biodegradablerobotics/biodegradablerobotics.github.io/Code/SamplePynamicsCode-main/SamplePynamicsCode-main/README.md

# SamplePynamicsCode
Supplementary material for ICRA submission 20-2127

Please run 'FinalSimulation' after installing the required packages.
