biodegradablerobotics/biodegradablerobotics.github.io/gallery.md

# Gallery

All images in the repo appear in assignments or are unnecessary duplicates. 

All images can be found [here](https://github.com/biodegradablerobotics/biodegradablerobotics.github.io/tree/main/Images)

A summary of the images of this project is below

## Conceptual CAD Design



## Conceptual Prototype Design

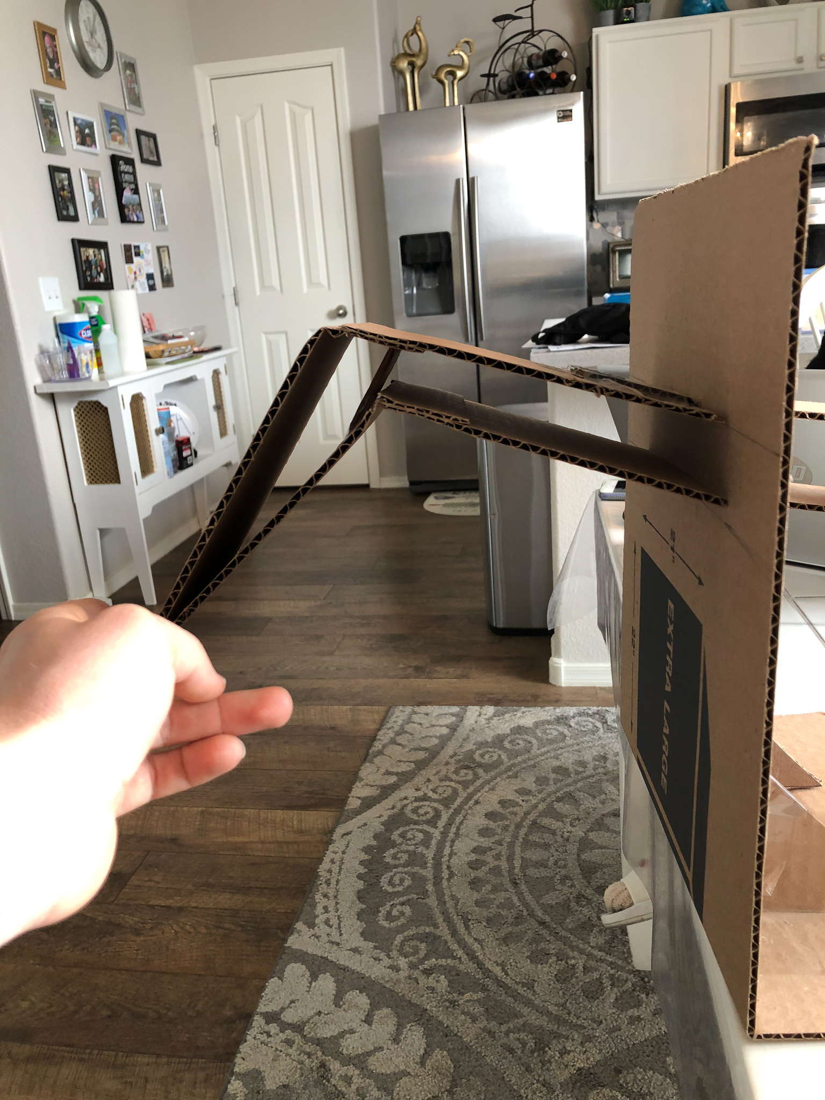
[picture p8: Images/IMG_8056.jpg]


## Foldable CAD Design

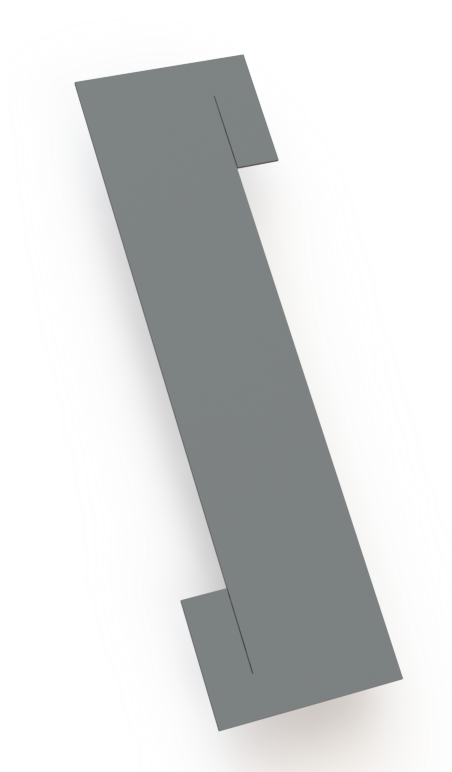
[picture p9: Images/flat - Copy.png]

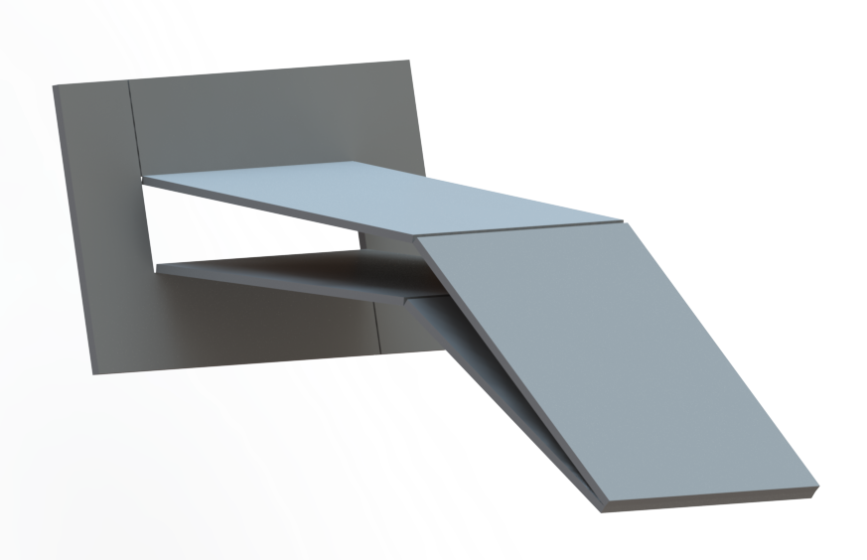
[picture p10: Images/folded.png]


## Foldable Protoype Design

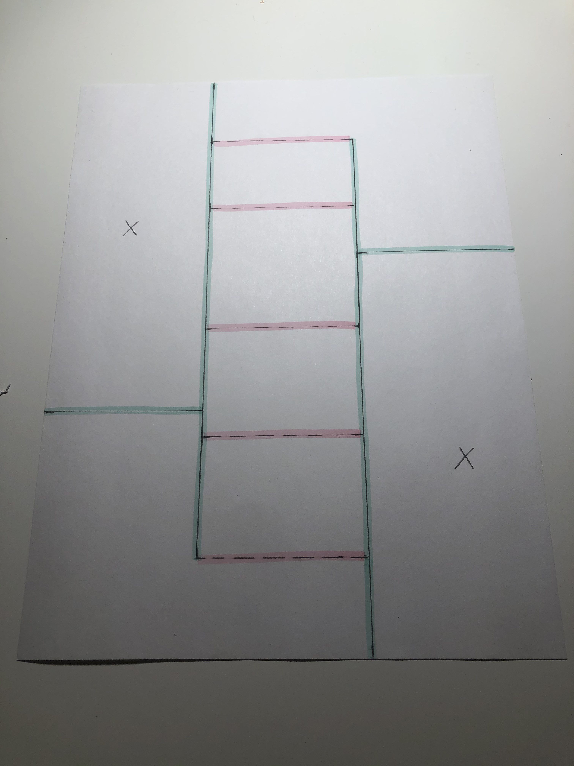
[picture p11: Images/flatpaper.jpg]

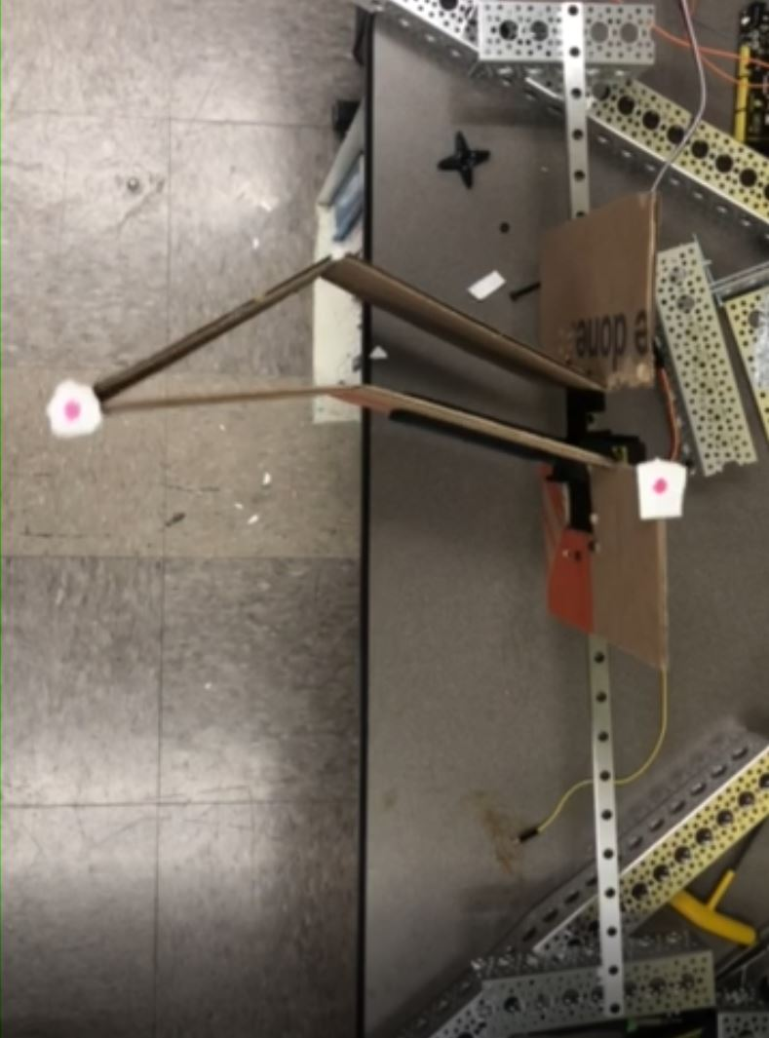
[picture p12: Images/finalproto.JPG]


## Final Simulation

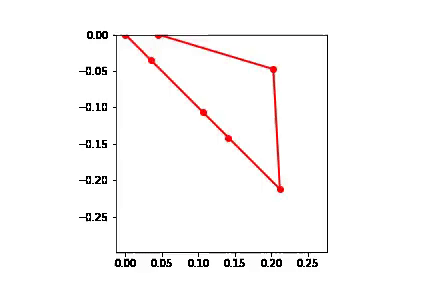
[picture p13: Images/FINALFLAPgif.gif]


## Final Test
