biodegradablerobotics/biodegradablerobotics.github.io/Bibliography.md

# Bibliography

[HOME](index.md)

[1]“Mallard,” Wikipedia, 19-Feb-2021. [Online]. Available: https://en.wikipedia.org/wiki/Mallard.
[Accessed: 28-Feb-2021].

[2] “Mallard Identification, All About Birds, Cornell Lab of Ornithology,” , All About Birds, Cornell
Lab of Ornithology, 2019. [Online]. Available: https://www.allaboutbirds.org/guide/Mallard/id.
[Accessed: 28-Feb-2021].

[3] W. W. Cochran, M. S. Bowlin, and M. Wikelski, “Wingbeat frequency and flap-pause ratio
during natural migratory flight in thrushes,” OUP Academic, 02-Jun-2008. [Online]. Available:
https://academic.oup.com/icb/article/48/1/134/627446. [Accessed: 28-Feb-2021].

[4] K. D. Earls, “Kinematics and mechanics of ground take-off in the starling Sturnis vulgaris and
the quail Coturnix coturnix,” Journal of Experimental Biology, 15-Feb-2000. [Online]. Available:
https://jeb.biologists.org/content/203/4/725. [Accessed: 28-Feb-2021].

[5] U. M. Norberg, “WING DESIGN AND MIGRATORY FLIGHT,” Brill, 12-Apr-1995. [Online].
Available: https://brill.com/view/journals/ijee/41/3/article-p297_11.xml. [Accessed: 28-Feb-2021].

[6] T. Liu, W. M. University, K. Kuykendoll, N. A. S. A. L. R. Center, R. Rhew, S. Jones, C.
Harvey, J. P. Calogero, K. Kitamura, K. Kitamura, Gavin K. Ananda and Michael S. Selig, D.
Kumar, M. Hamdaoui, S. Klän, Pradeep Gopalakrishnan and Danesh K. Tafti, J. T. Black, C.
Svanberg, S. Pantula, J. Jackson, R. Unger, S. Bansmer, and W. L. S. Pantula, “Avian Wing
Geometry and Kinematics,” AIAA Journal, 02-May-2012. [Online]. Available:
https://arc.aiaa.org/doi/abs/10.2514/1.16224?casa_token=r6aivCuGqMgAAAAA%3Ap7HvCTCP
ssW98Qedh3qjCwQa3h6oTVcNZ6BCSFze0NS6uCvBZKfUV_2CfwQQ2x-zJE9muAHnl9A&.
[Accessed: 28-Feb-2021].

[7] Send, W. & Fischer, M. & Jebens, K. & Mugrauer, R. & Nagarathinam, A. & Scharstein, F..
(2012). Artificial hinged-wing bird with active torsion and partially linear kinematics. 28th
Congress of the International Council of the Aeronautical Sciences 2012, ICAS 2012. 2.
1148-1157.

[8] “Festo Bionic Flying Fox,” Pneumatic & electric automation technology, Mar-2018. [Online].
Available: https://www.festo.com/PDF_Flip/corp/Festo_BionicFlyingFox/en/. [Accessed:
28-Feb-2021].

[9] F. Nickols and Y. J. Lin, "Feathered tail and pygostyle for the flying control of a bio-mimicking
eagle bird robot," 2017 IEEE International Conference on Cybernetics and Intelligent Systems
(CIS) and IEEE Conference on Robotics, Automation and Mechatronics (RAM), Ningbo, China,
2017, pp. 556-561, doi: 10.1109/ICCIS.2017.8274837.
8

[10] C.-S. Lin, C. Hwu, and W.-B. Young, “The thrust and lift of an ornithopter's membrane wings
with simple flapping motion,” Aerospace Science and Technology, 01-Dec-2005. [Online].
Available: https://www.sciencedirect.com/science/article/abs/pii/S1270963805001525.
[Accessed: 28-Feb-2021].

[11] J. W. Gerdes, S. K. Gupta, and S. A. Wilkerson, “A Review of Bird-Inspired Flapping Wing
Miniature Air Vehicle Designs,” Journal of Mechanisms and Robotics, 01-May-2012. [Online].
Available:
https://asmedigitalcollection.asme.org/mechanismsrobotics/article-abstract/4/2/021003/467462/
A-Review-of-Bird-Inspired-Flapping-Wing-Miniature?redirectedFrom=fulltext. [Accessed:
28-Feb-2021].

[12] “BEGINNERS FPV DRONE GUIDE,” Custom Quads. [Online]. Available:
https://customquads.com.au/pages/fpv-beginners-start-here#:~:text=To%20build%20a%20stand
ard%20FPV,800%20grams%20with%20a%20battery. [Accessed: 28-Feb-2021].

[13] “Pololu - 150:1 Micro Metal Gearmotor MP 6V,” Pololu Robotics & Electronics. [Online].
Available: https://www.pololu.com/product/2368/specs. [Accessed: 07-Feb-2021].

[14] “AKZYTUE 3.7V 400mAh 802525 Lipo Battery Rechargeable Lithium Polymer ion Battery
Pack with JST Connector,” Amazon.com. [Online]. Available:
https://www.amazon.com/AKZYTUE-Battery-Rechargeable-Lithium-Connector/dp/B07TVDNQN
S/ref=sr_1_2?dchild=1&keywords=3.7V+400mAh+Lithium+Polymer&qid=1612665237&s=hpc&
sr=1-2. [Accessed: 06-Feb-2021].

[15] T. Allen and Y. Tavares, “Planes and Birds: Minimizing Energy,” Santa Fe College, 2018.
[Online]. Available: https://www.sfcollege.edu/Assets/sf/rue/pdfs/2017/allen.pdf. [Accessed:
28-Feb-2021].

[16] Caramin, Bénédicte & Dunn, Iain & Ney, Rauno & Klawikowski, Yvonne & Duarte, Abel &
Malheiro, Benedita & Ribeiro, Cristina & Ferreira, Fernando & Silva, Manuel & Ferreira, Paulo &
Guedes, Pedro. (2015). Design and Implementation of a Biologically Inspired Flying Robot - An
EPS@ISEP 2014 Spring Project. 10.1145/2808580.2808612

[17] Zoheir Aboura, Nabil Talbi, Samir Allaoui, Malk Benzeggagh. Elastic behavior of corrugated cardboard: Experiments and Modeling. Composite Structures, Elsevier, 2004, 63 (1), pp.53-62. 

[18] [https://nbviewer.jupyter.org/url/biodegradablerobotics.github.io/Code/VirtualJoint.ipynb](https://nbviewer.jupyter.org/url/biodegradablerobotics.github.io/Code/VirtualJoint.ipynb)

[HOME](index.md)
