biodegradablerobotics/biodegradablerobotics.github.io/cad.md

# CAD


Solidworks files can be downloaded [here](https://github.com/biodegradablerobotics/biodegradablerobotics.github.io/blob/main/Manufacturing/Solidworks%20files.zip)

# DXF
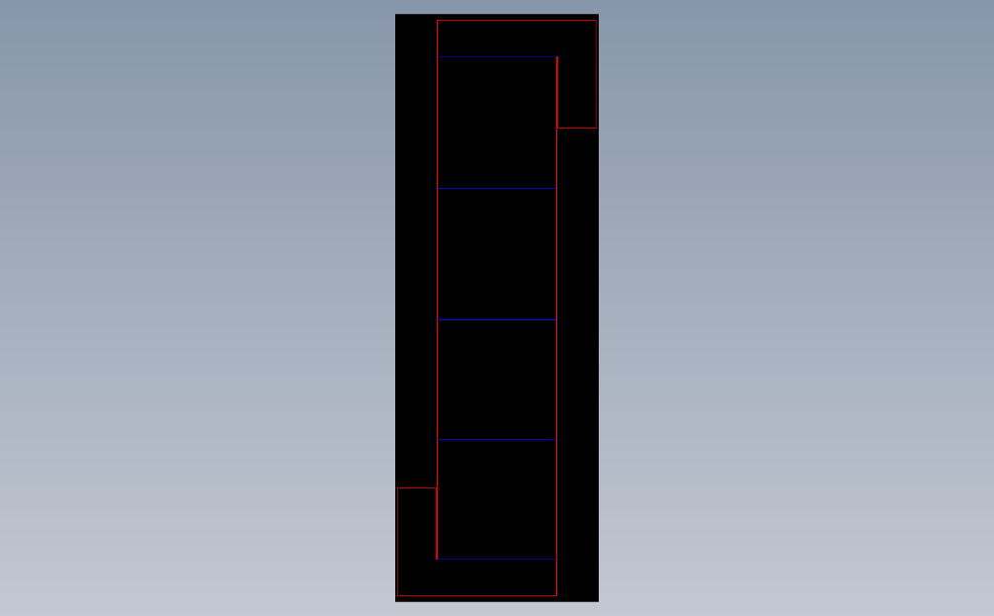
[picture p113: Manufacturing/images/design.png]


dxf files can be downloaded [here](https://github.com/biodegradablerobotics/biodegradablerobotics.github.io/blob/main/Manufacturing/dxf%20files.zip)
