biodegradablerobotics/biodegradablerobotics.github.io/Images/duckBG.jpg

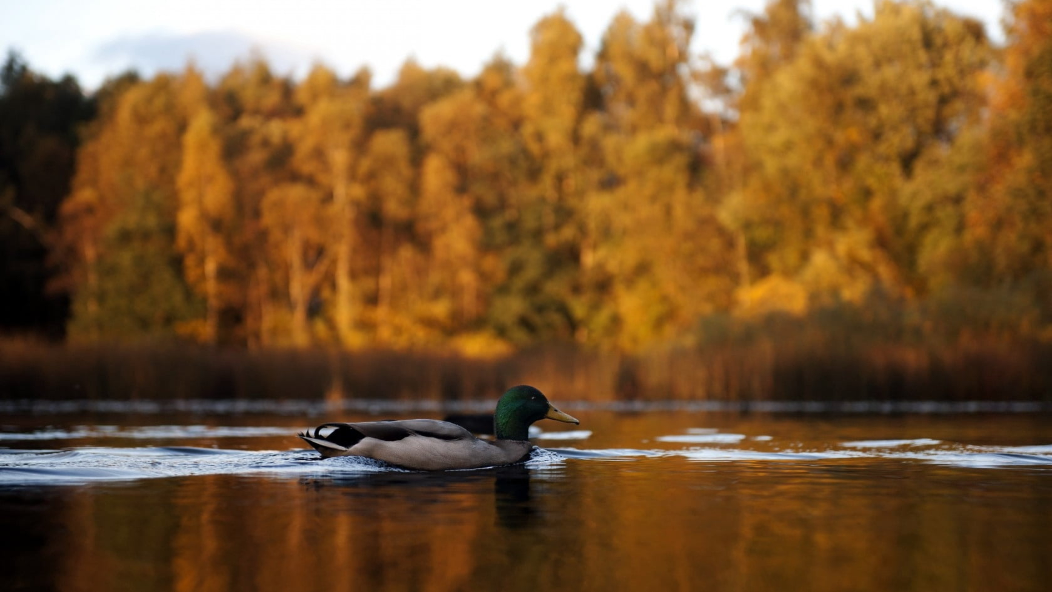
Images/duckBG.jpg
