biodegradablerobotics/biodegradablerobotics.github.io/Images/DynamicsB0/angles.png

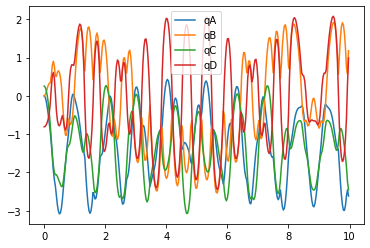
Images/DynamicsB0/angles.png
