biodegradablerobotics/biodegradablerobotics.github.io/Images/DynamicsB0/animation.gif

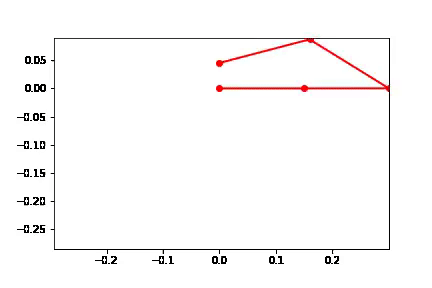
Images/DynamicsB0/animation.gif
