biodegradablerobotics/biodegradablerobotics.github.io/Images/DynamicsB0/energy.png

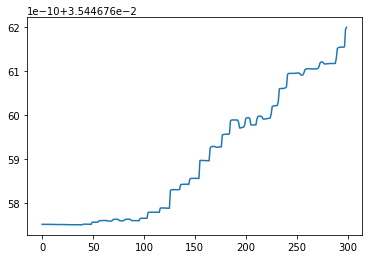
Images/DynamicsB0/energy.png
