biodegradablerobotics/biodegradablerobotics.github.io/Images/DynamicsB0/finalframe.png

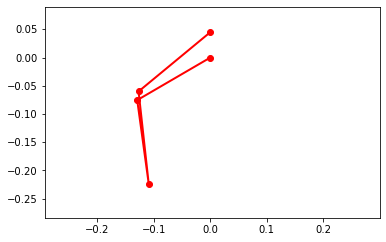
Images/DynamicsB0/finalframe.png
