biodegradablerobotics/biodegradablerobotics.github.io/Images/DynamicsB0/frames.png

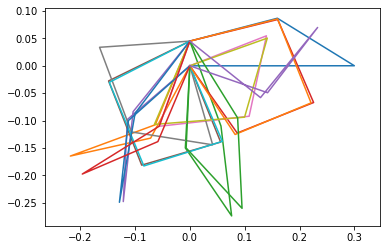
Images/DynamicsB0/frames.png
