biodegradablerobotics/biodegradablerobotics.github.io/Images/flat.png

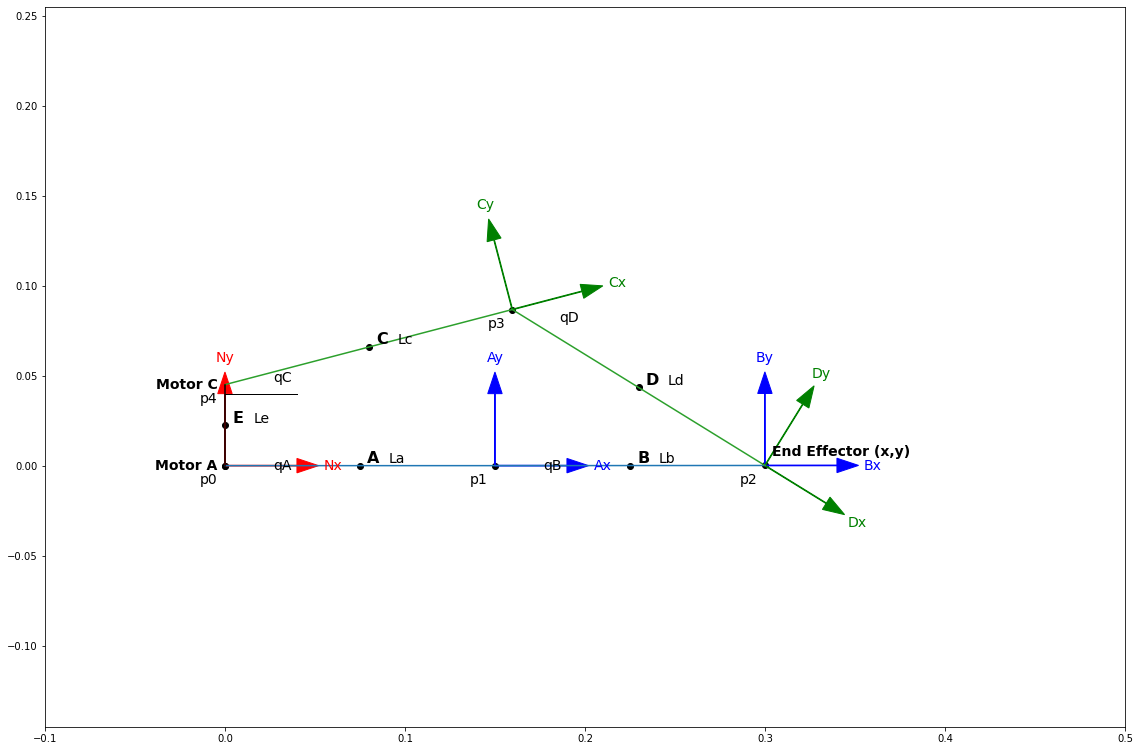
Images/flat.png
