biodegradablerobotics/biodegradablerobotics.github.io/Images/IMG_8039.jpg

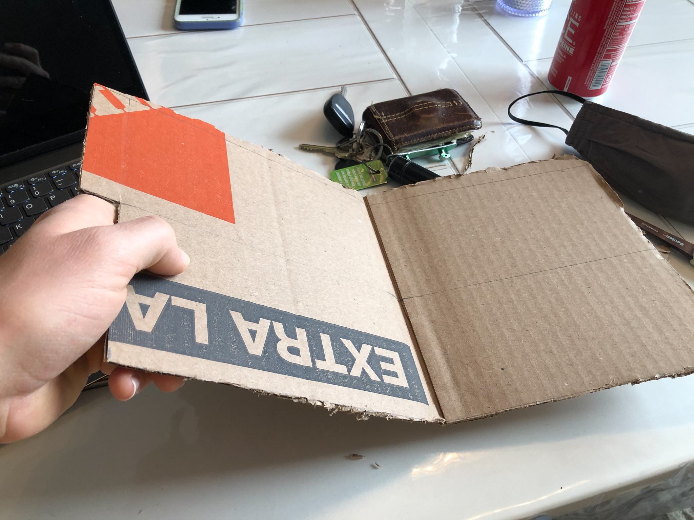
Images/IMG_8039.jpg
