biodegradablerobotics/biodegradablerobotics.github.io/Images/IMG_8041.jpg

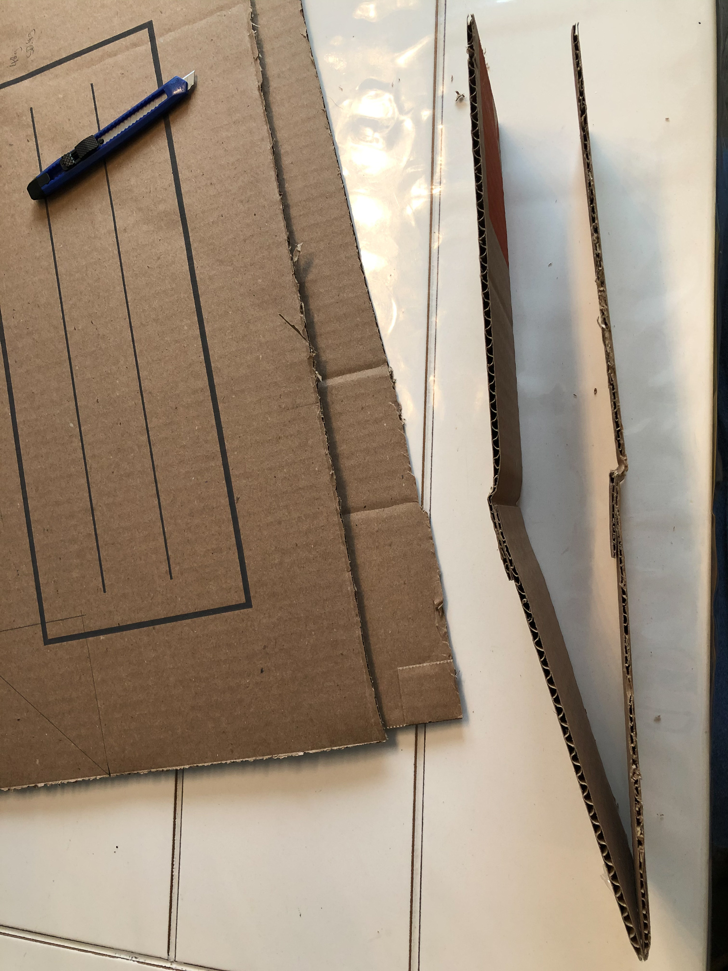
Images/IMG_8041.jpg
