biodegradablerobotics/biodegradablerobotics.github.io/Images/IMG_8042.jpg

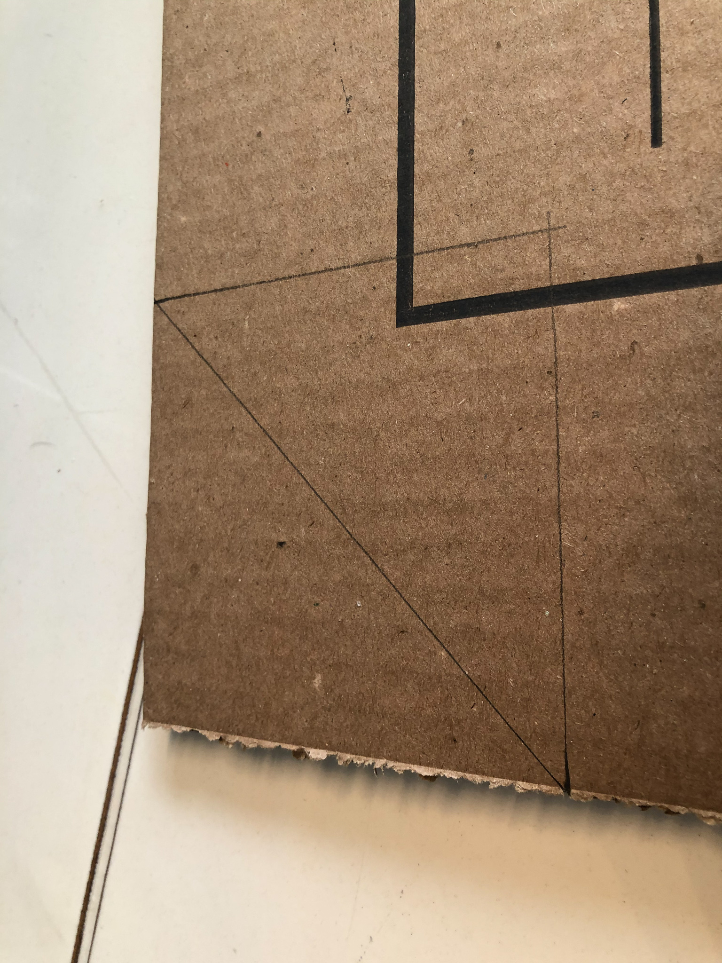
Images/IMG_8042.jpg
