biodegradablerobotics/biodegradablerobotics.github.io/Images/IMG_8043.jpg

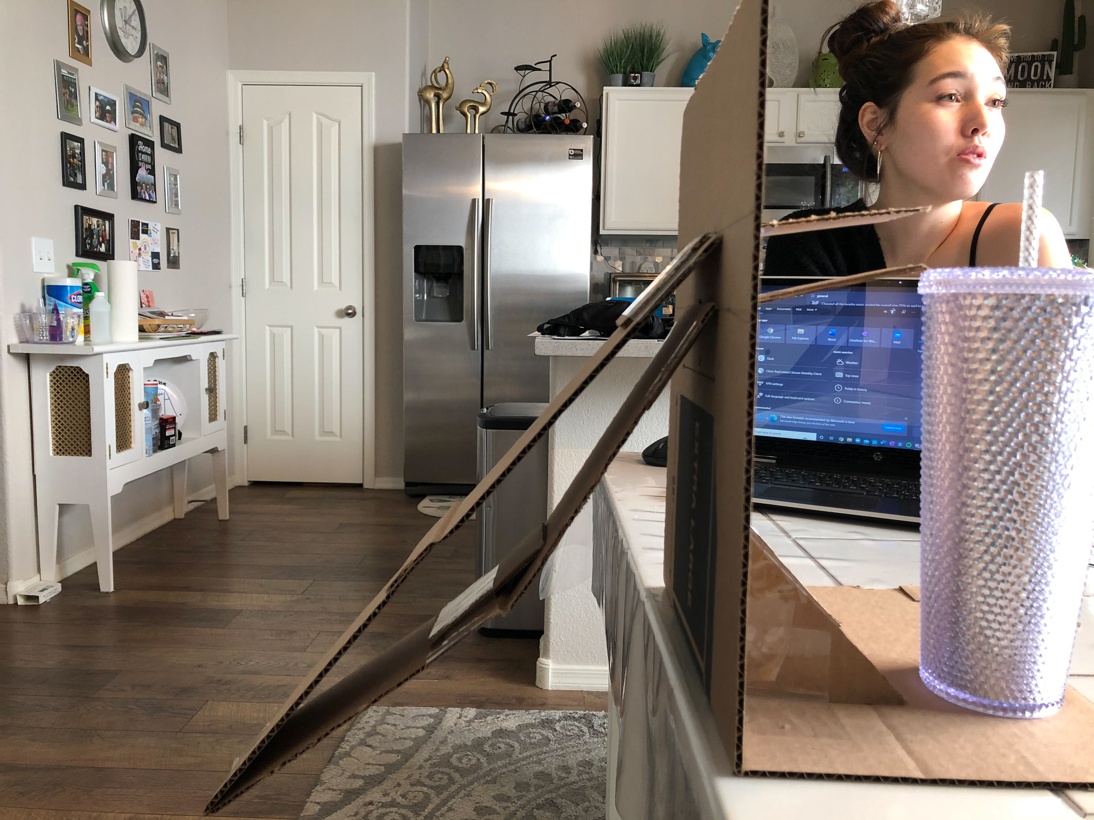
Images/IMG_8043.jpg
