biodegradablerobotics/biodegradablerobotics.github.io/Images/IMG_8046.jpg

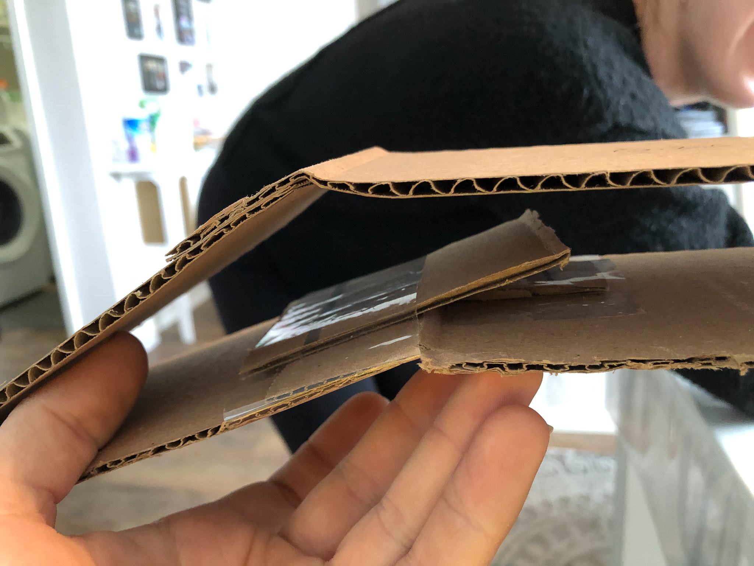
Images/IMG_8046.jpg
