biodegradablerobotics/biodegradablerobotics.github.io/Images/IMG_8047.jpg

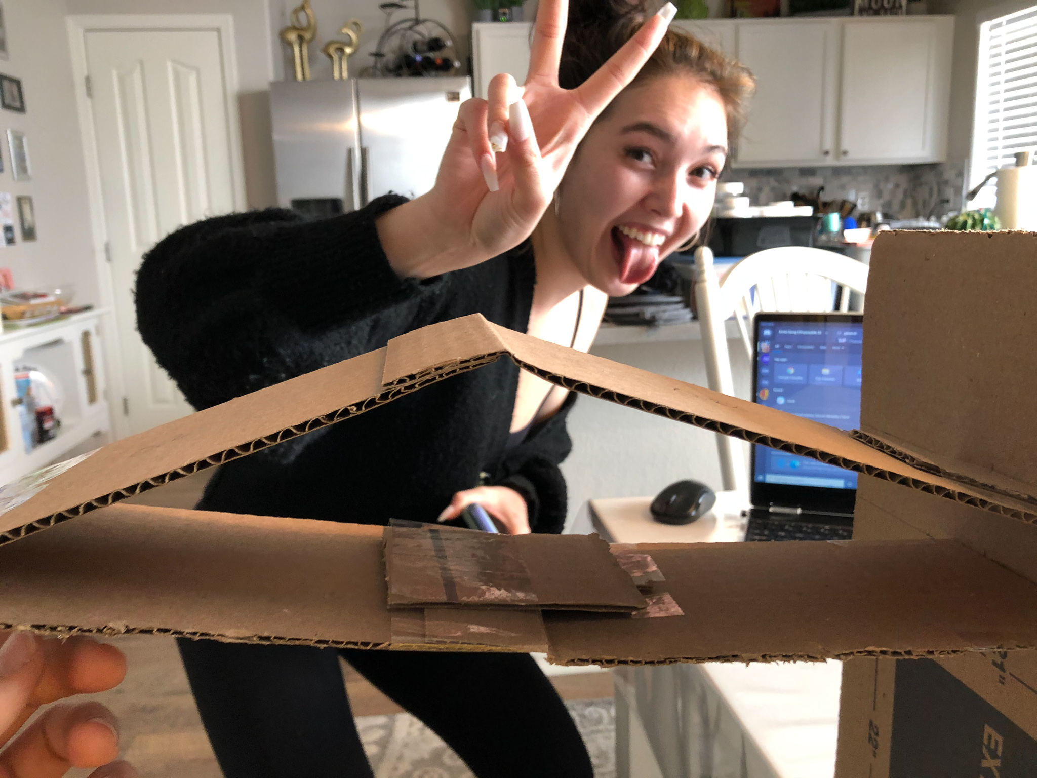
Images/IMG_8047.jpg
