biodegradablerobotics/biodegradablerobotics.github.io/Images/IMG_8052.jpg

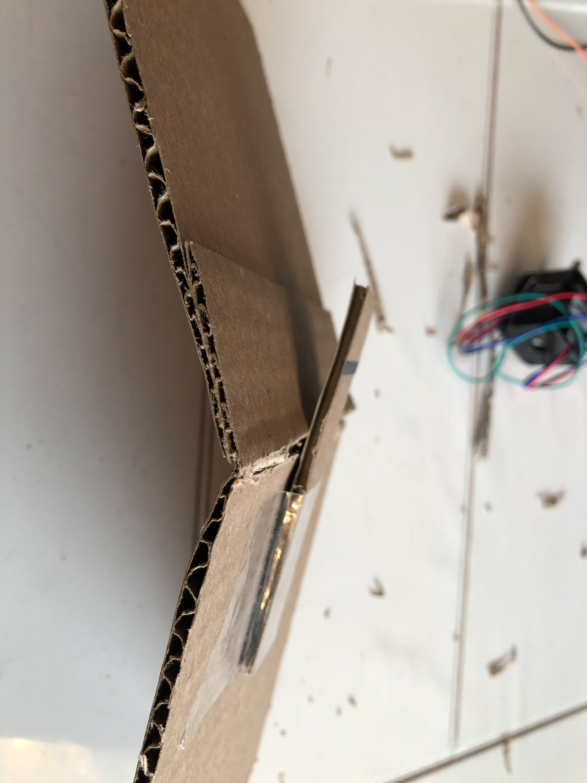
Images/IMG_8052.jpg
