biodegradablerobotics/biodegradablerobotics.github.io/Images/new graph.png

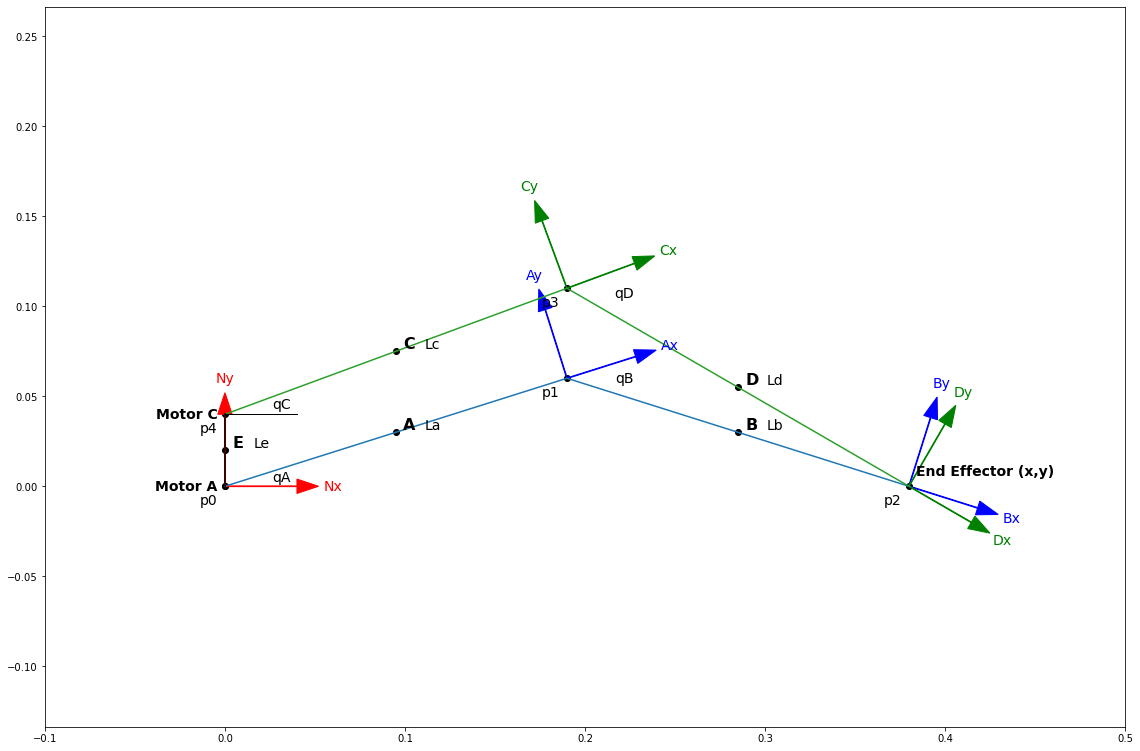
Images/new graph.png
