biodegradablerobotics/biodegradablerobotics.github.io/Images/paper wing reduce.jpeg

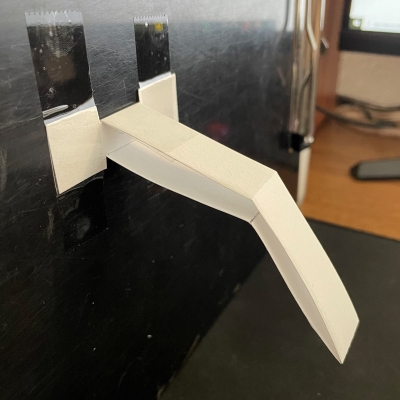
Images/paper wing reduce.jpeg
