biodegradablerobotics/biodegradablerobotics.github.io/Images/Servo.PNG

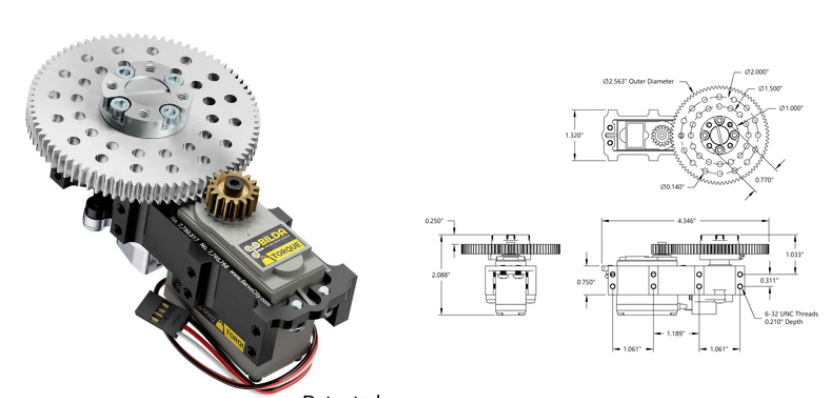
Images/Servo.PNG
