biodegradablerobotics/biodegradablerobotics.github.io/Images/tracker_sim.jpg

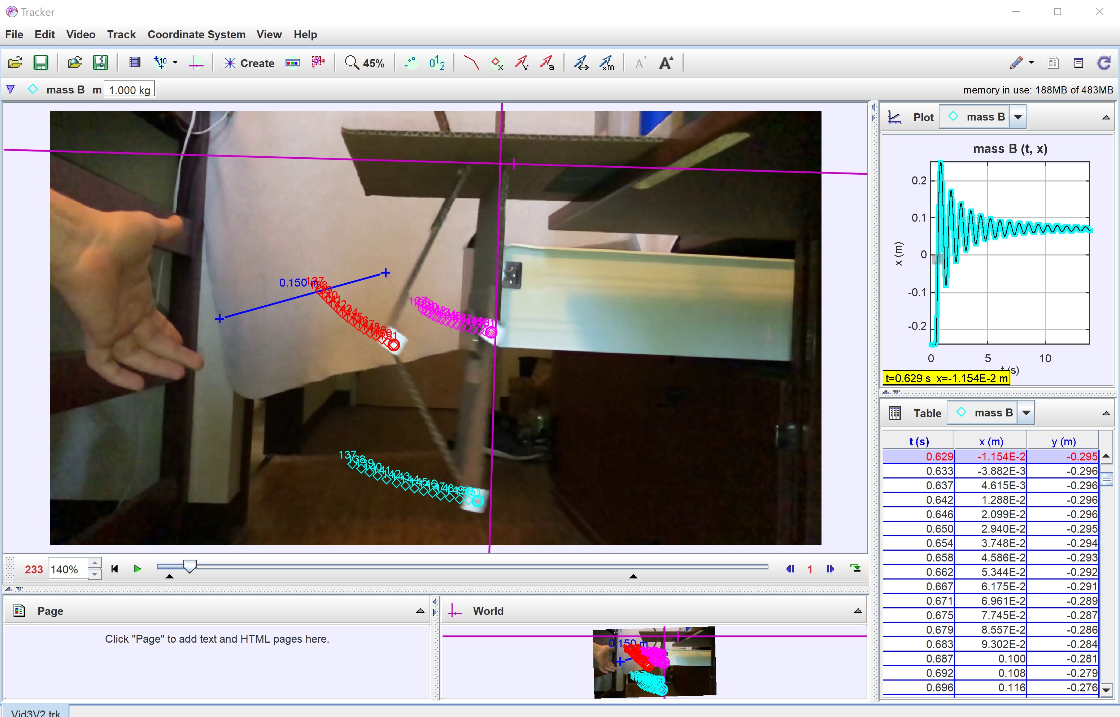
Images/tracker_sim.jpg
