biodegradablerobotics/biodegradablerobotics.github.io/Images/wingdiagram.png

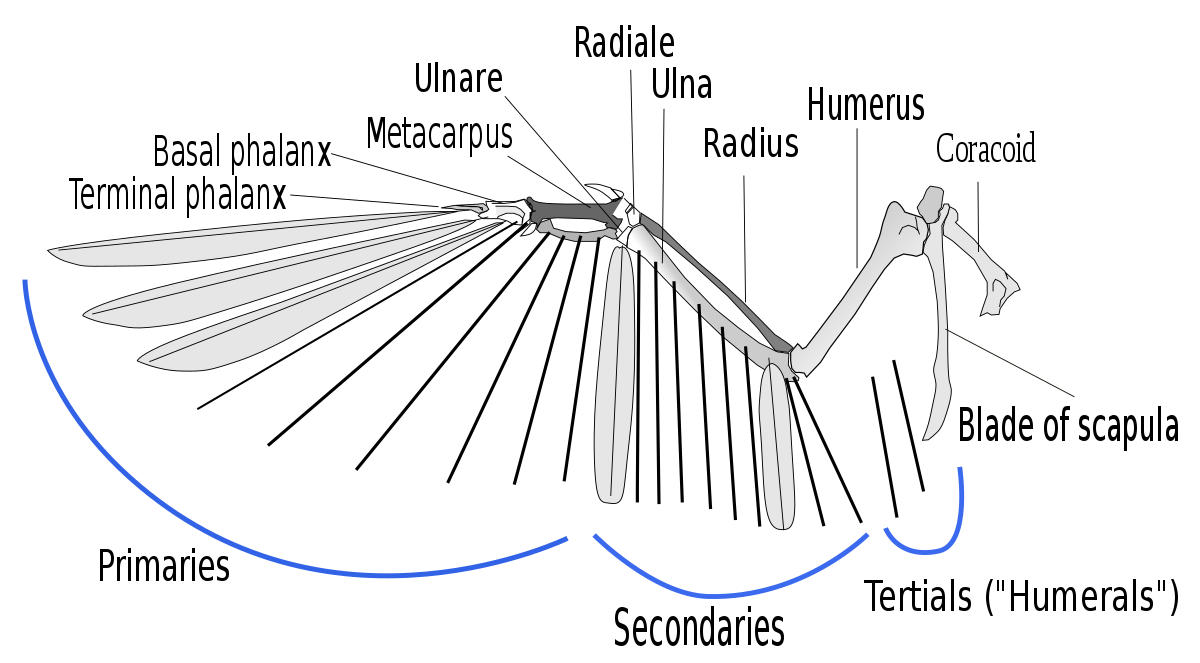
Images/wingdiagram.png
