biodegradablerobotics/biodegradablerobotics.github.io/Manufacturing/SW/folded.SLDASM

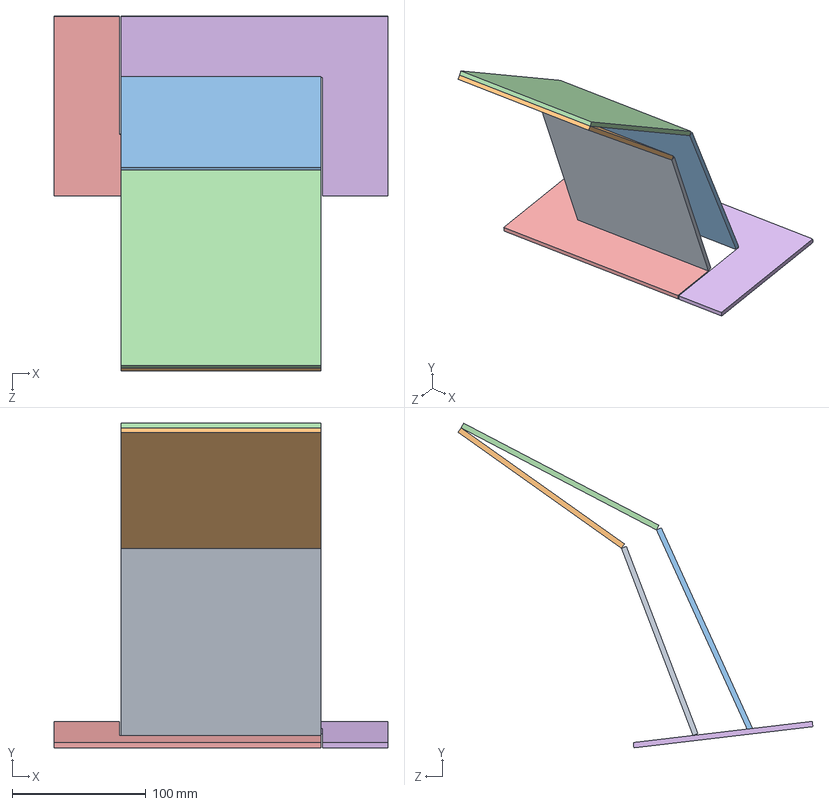
[picture p147: CAD file, 2021-04-12]
Manufacturing/SW/folded.SLDASM
250.0 x 243.0 x 265.7 mm
A
B
C
D
EA
EC
