biodegradablerobotics/biodegradablerobotics.github.io/SolidWorks/Compliant/Compliant Assembly.SLDASM

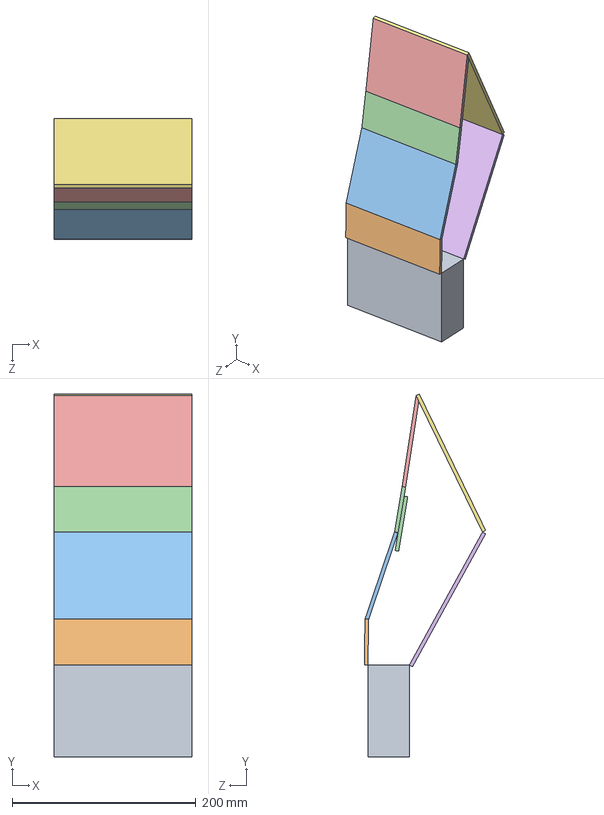
[picture p148: CAD file, 2021-03-20]
SolidWorks/Compliant/Compliant Assembly.SLDASM
150.0 x 394.7 x 132.1 mm
E
Aa
Ab
Ba
Bb
C
D
