biodegradablerobotics/biodegradablerobotics.github.io/Manufacturing/SW/flat.SLDASM

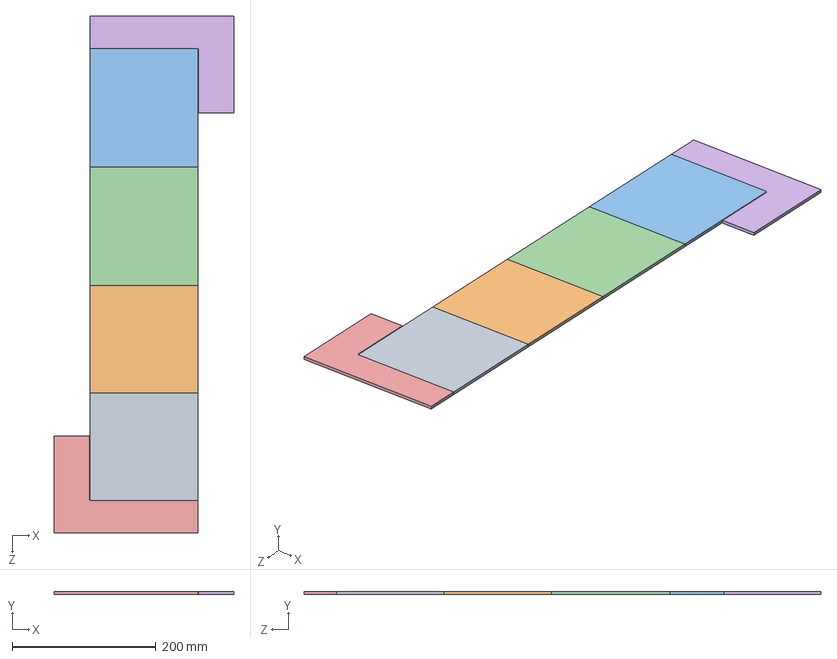
[picture p149: CAD file, 2021-04-12]
Manufacturing/SW/flat.SLDASM
250.0 x 4.00 x 720.0 mm
A
B
C
D
EA
EC
