biodegradablerobotics/biodegradablerobotics.github.io/SolidWorks/Wing Assembly.SLDASM

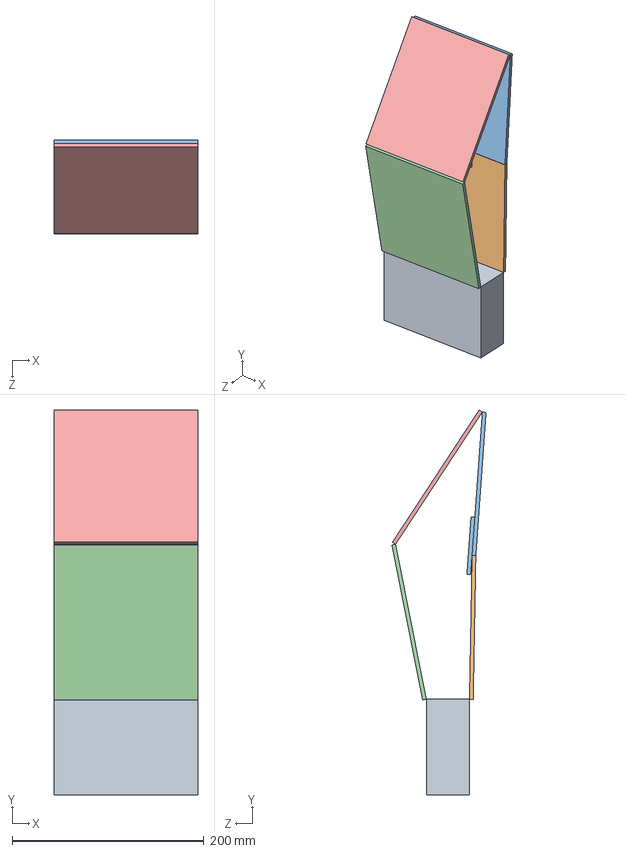
[picture p150: CAD file, 2021-03-15]
SolidWorks/Wing Assembly.SLDASM
150.0 x 402.0 x 98.4 mm
E
A
B
C
D
