biodegradablerobotics/biodegradablerobotics.github.io/Manufacturing/first_pass0.dxf

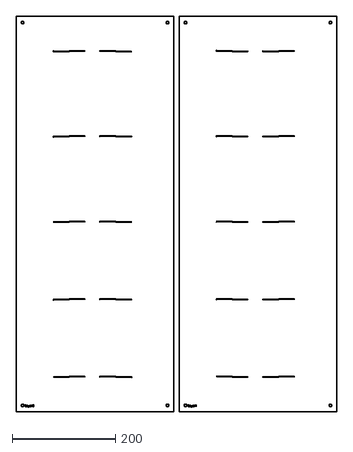
[picture p151: CAD file, 2021-04-26]
Manufacturing/first_pass0.dxf
619.8 x 764.9
