biodegradablerobotics/biodegradablerobotics.github.io/Manufacturing/SW/EA.SLDPRT

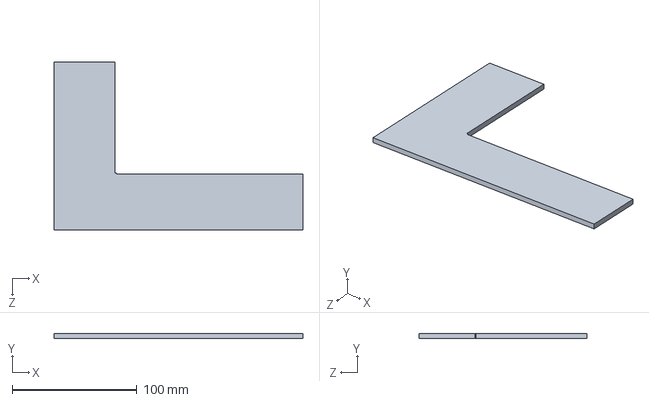
[picture p152: CAD file, 2021-04-12]
Manufacturing/SW/EA.SLDPRT
200.0 x 4.00 x 135.0 mm
