biodegradablerobotics/biodegradablerobotics.github.io/SolidWorks/Compliant/Ba.SLDPRT

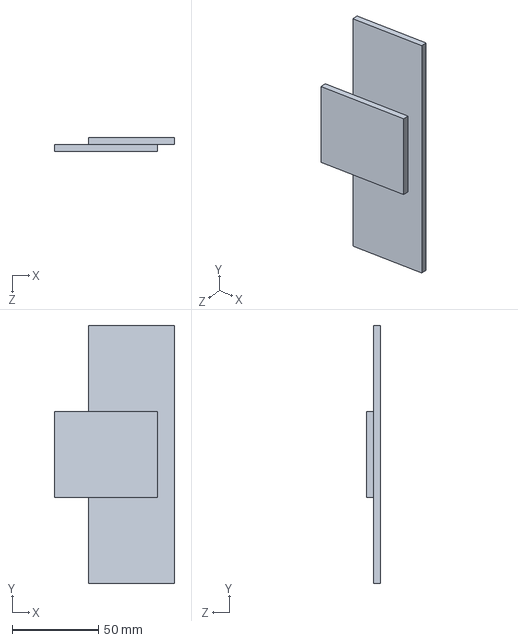
[picture p153: CAD file, 2021-03-20]
SolidWorks/Compliant/Ba.SLDPRT
70.0 x 150.0 x 8.00 mm
