biodegradablerobotics/biodegradablerobotics.github.io/Manufacturing/first_pass2.dxf

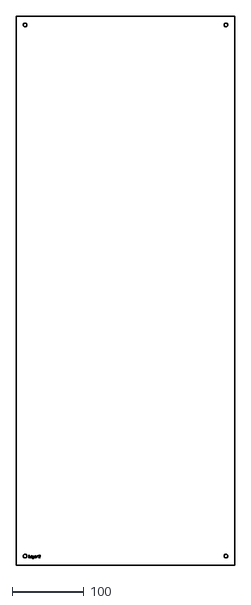
[picture p154: CAD file, 2021-04-26]
Manufacturing/first_pass2.dxf
304.9 x 764.9
