biodegradablerobotics/biodegradablerobotics.github.io/SolidWorks/D.SLDPRT

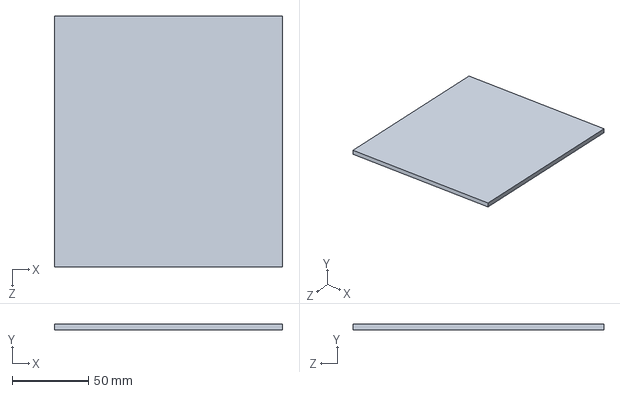
[picture p155: CAD file, 2021-03-20]
SolidWorks/D.SLDPRT
150.0 x 4.00 x 165.0 mm
