biodegradablerobotics/biodegradablerobotics.github.io/Manufacturing/final_cut.dxf

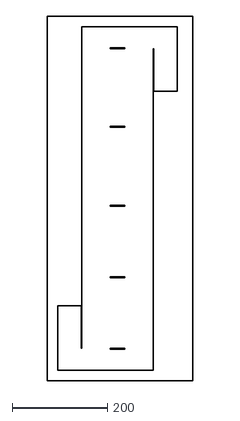
[picture p156: CAD file, 2021-04-26]
Manufacturing/final_cut.dxf
304.9 x 764.9
