biodegradablerobotics/biodegradablerobotics.github.io/SolidWorks/Compliant/Ab.SLDPRT

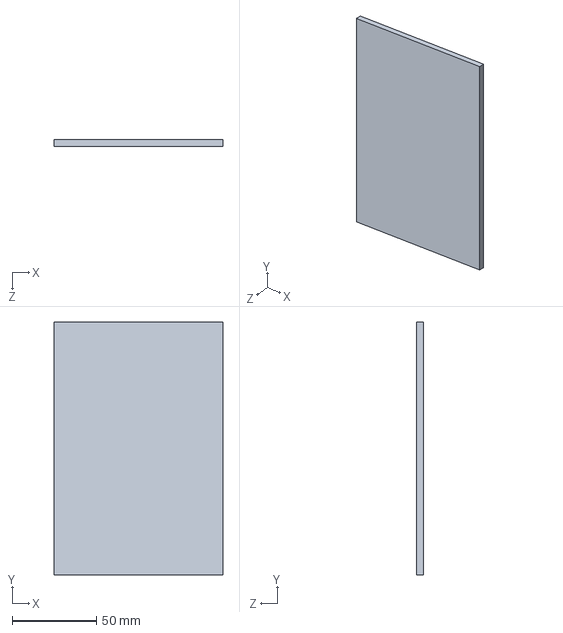
[picture p157: CAD file, 2021-03-20]
SolidWorks/Compliant/Ab.SLDPRT
100.0 x 150.0 x 4.00 mm
