biodegradablerobotics/biodegradablerobotics.github.io/Manufacturing/design.dxf

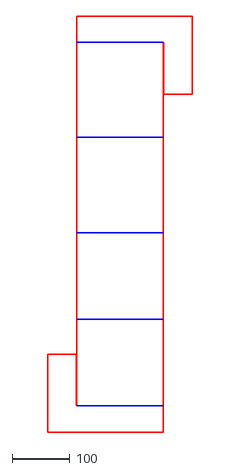
[picture p158: CAD file, 2021-04-26]
Manufacturing/design.dxf
250.0 x 720.0
