biodegradablerobotics/biodegradablerobotics.github.io/Manufacturing/first_pass1.dxf

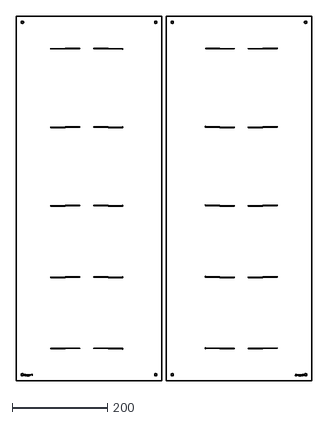
[picture p159: CAD file, 2021-04-26]
Manufacturing/first_pass1.dxf
619.8 x 764.9
