biodegradablerobotics/biodegradablerobotics.github.io/SolidWorks/B.SLDPRT

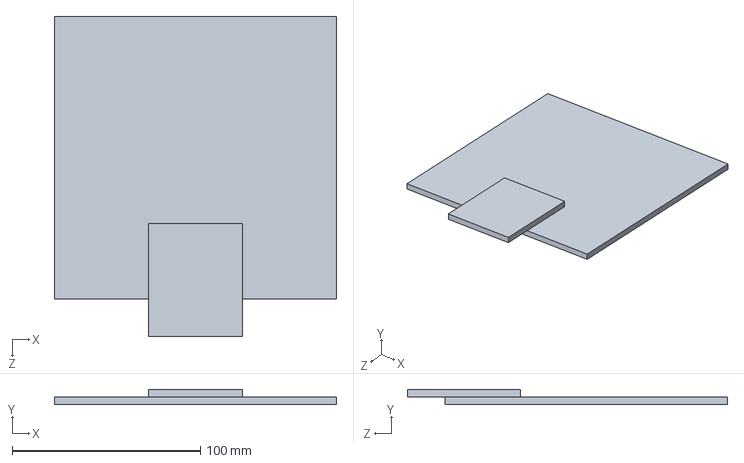
[picture p160: CAD file, 2021-03-15]
SolidWorks/B.SLDPRT
150.0 x 8.00 x 170.0 mm
