biodegradablerobotics/biodegradablerobotics.github.io/SolidWorks/Compliant/Aa.SLDPRT

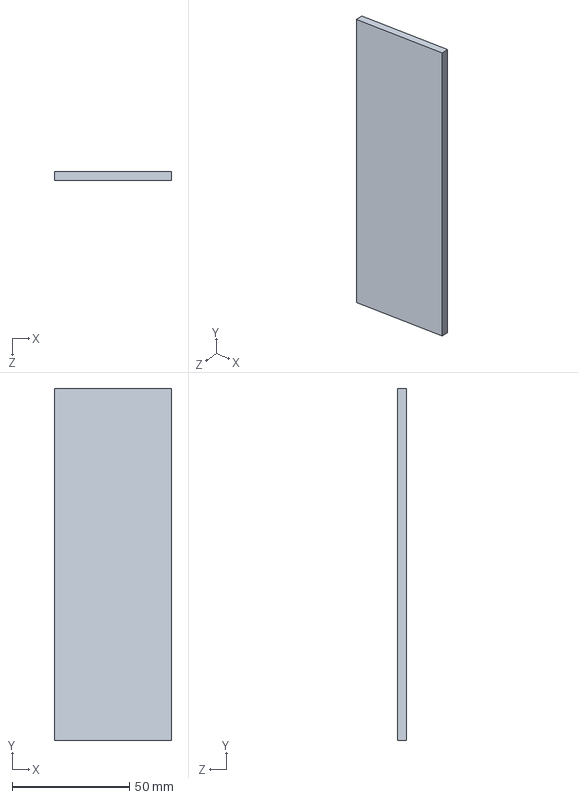
[picture p161: CAD file, 2021-03-20]
SolidWorks/Compliant/Aa.SLDPRT
50.0 x 150.0 x 4.00 mm
