biodegradablerobotics/biodegradablerobotics.github.io/SolidWorks/A.SLDPRT

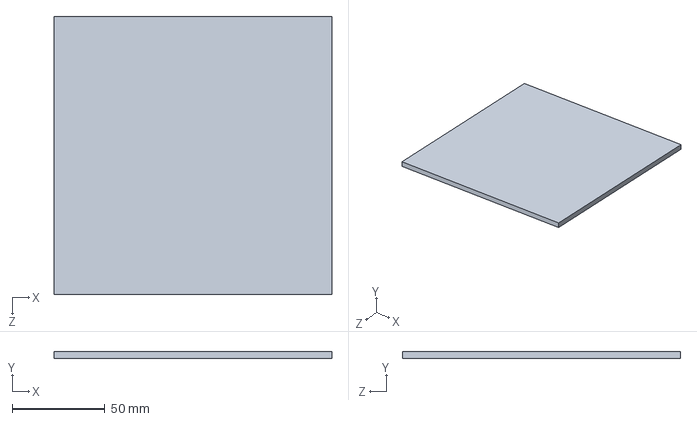
[picture p162: CAD file, 2021-03-15]
SolidWorks/A.SLDPRT
150.0 x 4.00 x 150.0 mm
