biodegradablerobotics/biodegradablerobotics.github.io/SolidWorks/Compliant/Da.SLDPRT

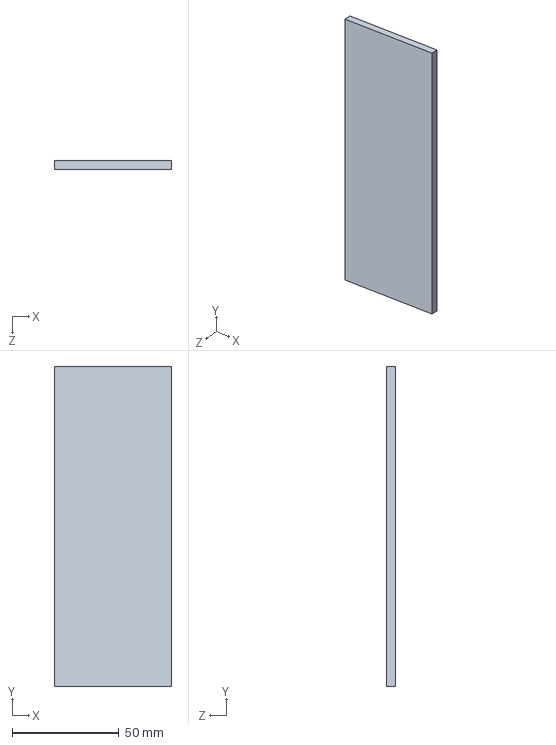
[picture p163: CAD file, 2021-03-17]
SolidWorks/Compliant/Da.SLDPRT
55.0 x 150.0 x 4.00 mm
