biodegradablerobotics/biodegradablerobotics.github.io/SolidWorks/Compliant/Db.SLDPRT

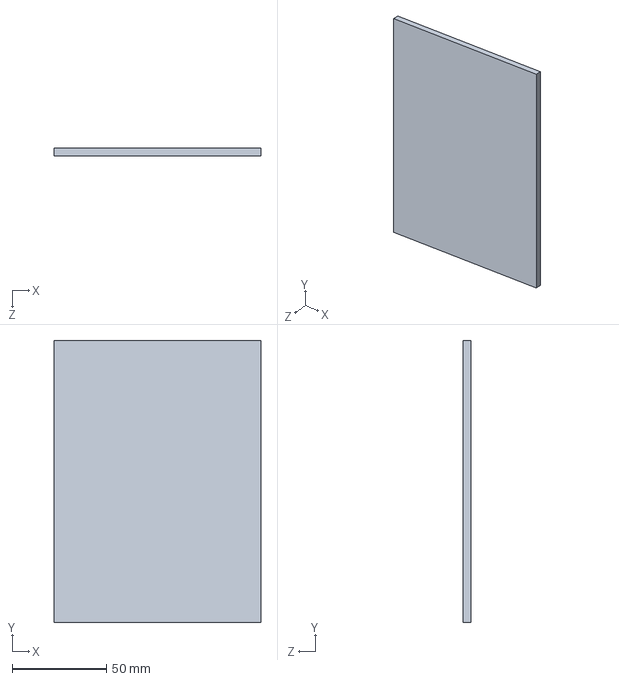
[picture p164: CAD file, 2021-03-17]
SolidWorks/Compliant/Db.SLDPRT
110.0 x 150.0 x 4.00 mm
