biodegradablerobotics/biodegradablerobotics.github.io/Manufacturing/SW/2D1Layer.SLDPRT

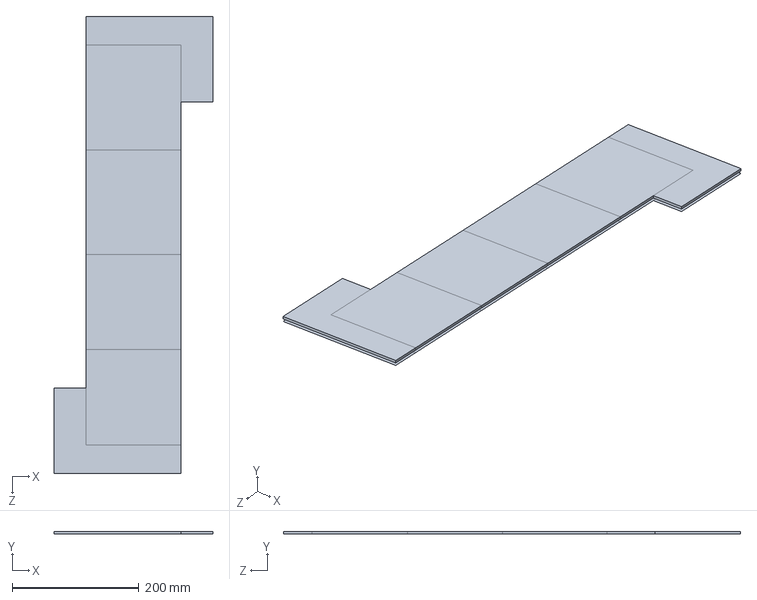
[picture p165: CAD file, 2021-04-09]
Manufacturing/SW/2D1Layer.SLDPRT
250.0 x 8.00 x 720.0 mm
