biodegradablerobotics/biodegradablerobotics.github.io/SolidWorks/Compliant/E.SLDPRT

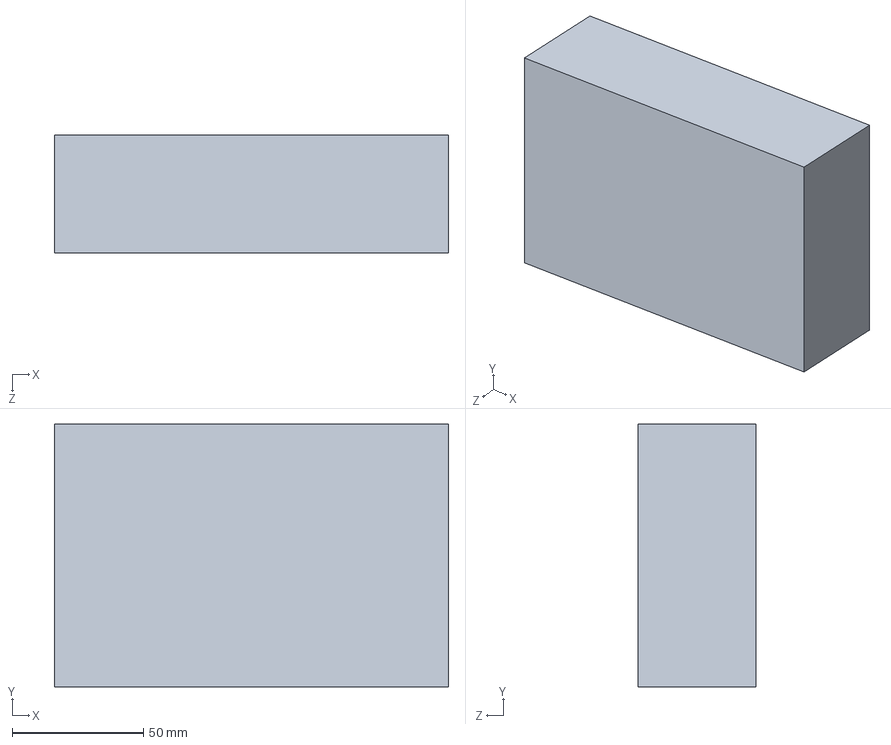
[picture p166: CAD file, 2021-03-15]
SolidWorks/Compliant/E.SLDPRT
150.0 x 100.0 x 45.0 mm
