biodegradablerobotics/biodegradablerobotics.github.io/(list of files, cad)

Other CAD files:
SolidWorks/2D_5bar.SLDPRT
SolidWorks/C.SLDPRT
Manufacturing/SW/EC.SLDPRT
SolidWorks/Compliant/Bb.SLDPRT
Manufacturing/SW/C.SLDPRT
Manufacturing/SW/A.SLDPRT
Manufacturing/SW/D.SLDPRT
SolidWorks/Compliant/Ca.SLDPRT
Manufacturing/SW/B.SLDPRT
SolidWorks/Compliant/Cb.SLDPRT
Manufacturing/SW/flat.SLDDRW
