biodegradablerobotics/biodegradablerobotics.github.io/(commit log)

2021-02-11 wing video
2021-02-12 Create Team System Kinematics.ipynb
2021-02-12 Create Team System Kinematics-checkpoint.ipynb
2021-02-15 Update Team System Kinematics-checkpoint.ipynb
2021-02-15 Update Team System Kinematics.ipynb
2021-02-15 wing kinematics
2021-02-16 update wing kinematics
2021-02-17 Create Wing Kinematics-checkpoint.ipynb
2021-02-17 Create paper wing reduce.jpeg
2021-02-17 Create paper wing.jpeg
2021-02-17 Create Wing Kinematics.ipynb
2021-02-22 SW and renders
    [2D_5bar.SLDPRT, A.SLDPRT, B.SLDPRT, C.SLDPRT, D.SLDPRT, E.SLDPRT, Wing Assembly.SLDASM]
2021-02-22 update force and velocity
2021-02-28 almost done
    [C.SLDPRT, D.SLDPRT]
2021-02-28 system kinematics pdf
2021-02-28 dynamics pdf
    [Wing Assembly.SLDASM]
2021-03-07 update SW
    [A.SLDPRT, B.SLDPRT, C.SLDPRT, E.SLDPRT, Wing Assembly.SLDASM]
2021-03-08 Create Material collection and initial prototyping.pdf
2021-03-15 dyn2 and redo SW
    [2D_5bar.SLDPRT, A.SLDPRT, B.SLDPRT, C.SLDPRT, D.SLDPRT, E.SLDPRT, Wing Assembly.SLDASM]
2021-03-15 virtual joint
2021-03-17 virtual joint solution
2021-03-17 compliant dynamics
    [Aa.SLDPRT, Ab.SLDPRT, Ba.SLDPRT, Bb.SLDPRT, Ca.SLDPRT, Cb.SLDPRT, Compliant Assembly.SLDASM, Da.SLDPRT]
2021-03-19 switching force doesnt work
2021-03-19 switching T
2021-03-20 it switches correctly now
2021-03-20 Everything but Aero
    [Aa.SLDPRT, Ab.SLDPRT, Ba.SLDPRT, Bb.SLDPRT, C.SLDPRT, Compliant Assembly.SLDASM, D.SLDPRT]
2021-03-20 no torque case
2021-03-27 Create Material collection and initial prototyping.docx
2021-04-11 small changes
    [design.dxf]
2021-04-26 I hope this doesnt break git
    [2D_5bar.SLDPRT]
2021-04-26 Create CAD and Designs
2021-04-26 Rename CAD and Designs to CAD.md
